Noel-1602/AirMouse/Core/Inc/main.h

#define LED_Pin GPIO_PIN_13
#define LED_GPIO_Port GPIOC
#define BTN_LEFT_Pin GPIO_PIN_12
#define BTN_LEFT_GPIO_Port GPIOB
#define BTN_RIGHT_Pin GPIO_PIN_13
#define BTN_RIGHT_GPIO_Port GPIOB
#define BTN_RECENTER_Pin GPIO_PIN_14
#define BTN_RECENTER_GPIO_Port GPIOB
