Noel-1602/AirMouse/Core/Inc/airmouse.h

#ifndef __AIRMOUSE_H__
#define __AIRMOUSE_H__

#ifdef __cplusplus
extern "C" {
#endif

#include "main.h"

/*
 * Axis mapping configuration:
 * Choose source from: gx, gy, gz
 * Signs: +1 or -1
 * Default: dx = gz, dy = gx
 */
#define X_SOURCE gz
#define Y_SOURCE gx
#define X_SIGN (-1)
#define Y_SIGN (1)

/* Mouse sensitivity multiplier */
#define SENSITIVITY 0.5f

/* Gyro dead zone in degrees per second */
#define DEADZONE_DPS 1.5f

/* Low-pass filter alpha factor (0.0 to 1.0) */
#define LPF_ALPHA 0.3f

/* Button debounce time in ms */
#define BUTTON_DEBOUNCE_MS 20

/* Auto-detect mode at startup: 1 = auto-detect USB vs Wireless, 0 = use OUTPUT_MODE_WIRELESS */
#define AUTO_DETECT_MODE 1

/* Output mode: 1 = HC-05 Wireless UART, 0 = USB HID (used if AUTO_DETECT_MODE is 0) */
#define OUTPUT_MODE_WIRELESS 1

/* Wireless packet transmission period in ms */
#define PACKET_PERIOD_MS 20

/* Output mode enum */
typedef enum output_mode_t {
  MODE_USB_HID = 0,
  MODE_WIRELESS = 1
} output_mode_t;

extern output_mode_t g_output_mode;

/* Global debug struct for GDB inspection */
typedef struct {
  int16_t gx_raw;
  int16_t gy_raw;
  int16_t gz_raw;
  float bias_x;
  float bias_y;
  float bias_z;
  int8_t dx;
  int8_t dy;
  uint8_t buttons;
  uint8_t enabled;
  output_mode_t g_output_mode;
} airmouse_debug_t;

extern volatile airmouse_debug_t g_airmouse_debug;

/* Function prototypes */
int airmouse_init(void);
void airmouse_step(void);

#ifdef __cplusplus
}
#endif

#endif /* __AIRMOUSE_H__ */
