Noel-1602/AirMouse/(commit log)

2026-10-27 Invert X axis direction (X_SIGN = -1)
2026-10-27 Runtime USB/wireless mode switch
2026-10-27 Add wiring diagram image
2026-10-27 Add tilt correction, pointer acceleration, precision mode, idle mode, and host smoothing
    - Tilt correction: roll estimation via MPU6050 accelerometer burst with complementary filter and gyro axis de-rotation
    - Pointer acceleration: 2D speed-based non-linear gain scaling preserving fractional remainders
    - Precision mode: optional button on PB15 with internal pull-up and sensitivity scaling
    - Idle mode: low-power WFI sleep and 500 ms keepalive packets after inactivity in wireless mode
    - Host smoothing: EMA filter with fractional remainder accumulation and auto-reset in airmouse_host.py
    - Link libm in CMakeLists.txt for transcendental math routines
2026-10-27 Add scroll mode support in firmware and host script
    - Replace precision mode with scroll wheel mode (SCROLL_MODE) on PB15
    - Support both momentary hold and toggle modes via SCROLL_TOGGLE
    - Use vertical gyroscope axis to generate scroll ticks with dead zone and tick limiting
    - Send wheel delta in 4th byte of USB HID report
    - Transmit scroll flag (bit 2) and ticks in wireless HC-05 packets
    - Add scroll handling, --scroll-scale, and --scroll-invert in airmouse_host.py
